Luke-Neumann/PowerMeter2/PCB Design/Final BOM.xlsx

Qty | Parts | Value | DIGI-KEY_PART_NUMBER | Device | Package | Description | DESCRIPTION | DIGI-KEY_PURCHASE_URL
1 | J2 |  | 609-3487-1-ND | CONN_03X2FEMALE_SMD | 2X3_SMD | Multi connection point. Often used as Generic Header-pin footprint for 0.1 inch spaced/style header connections
1 | D1 |  | 641-1458-1-ND | SCHOTTKY_DIODE | SMD_DIODE
1 | IC1 |  | 296-21828-1-ND | TL2575 | TO-263-6
5 | C3, C4, C10, C11, C12 | 0.1uF | 1276-1000-1-ND | 0.1UF-0603-25V-5% | 603 | 0.1µF ceramic capacitors
1 | C7 | 0.22uF | 399-7884-1-ND | 0.22UF-0603-25V-10% | 603 | 0.22µF ceramic capacitors
2 | R11, R12 | 100 | P100DBCT-ND | 100OHM-0603-1/4W-5% | 603 | 100Ω resistor
1 | C1 | 100uF | PCE3917CT-ND | CAP_POLF | F_CAP
4 | R15, R16, R17, R18 | 10k | 311-10KDCT-ND | 10KOHM-0603-1/10W-1% | 603 | 10kΩ resistor
1 | R14 | 11k | P11KDBCT-ND | RESISTOR0603 | 603 | Generic Resistor Package
1 | SW1 | 147873-1 | EG4576CT-ND | 147873-1 | SW_147873-1 | Switch Tactile OFF (ON) SPST Rectangular Button J-Bend 0.05A 24VDC 1.77N SMD T/R | Switch Tactile OFF _ON_ SPST Rectangular Button J-Bend 0.05A 24VDC 1.77N SMD T/R
1 | R13 | 150k | P150KDBCT-ND | 150KOHM-0603-1/10W-1% | 603 | 150kΩ resistor
1 | J1 | 1702473 | 277-2337-1-ND | 1702473 |  | Fixed Miniature Connectors, Spring Cage, Horizontal, SMD, 2 Pos | Fixed Miniature Connectors, Spring Cage, Horizontal, SMD, 2 Pos | https://www.digikey.com/product-detail/en/phoenix-contact/1702473/277-2337-1-ND/2643219
4 | R1, R2, R9, R10 | 1k | P1.0KBECT-ND | 1KOHM-0603-1/10W-1% | 603 | 1kΩ resistor
2 | C5, C6 | 22nF | 399-9043-1-ND | 22NF/22,000PF-0603-50V-10% | 603 | 0.022uF/22nF/22,000pF ceramic capacitors
1 | L1 | 330 uH | SRR1208-331KLCT-ND | DR125 | DR125
1 | C2 | 330uF | PCE5018CT-ND | CAP_POLF | F_CAP
2 | R3, R4 | 5.1k | P5.1KBECT-ND | RESISTOR0603 | 603 | Generic Resistor Package
4 | R5, R6, R7, R8 | 680 | P680GCT-ND | RESISTOR0603 | 0603_RESISTOR
1 | U2 | ADS1115IDGSR | 296-38849-1-ND | ADS1115IDGSR | SOP50P490X110-10N | 16-Bit ADC with Integrated MUX, PGA, Comparator, Oscillator, and Reference 10-VSSOP -40 to 125 | 16-Bit ADC with Integrated MUX, PGA, Comparator, Oscillator, and Reference 10-VSSOP -40 to 125 | https://www.digikey.com/product-detail/en/texas-instruments/ADS1115IDGSR/296-38849-1-ND/5142969
1 | U3 | AT90USB1286-MUR | AT90USB1286-MURCT-ND | AT90USB1286-MUR | PS
2 | LED2, LED3 | RED | 516-3074-1-ND | LED0603 | 0603_LED
2 | LED1, LED4 | GRN | 516-2493-1-ND | LED0603 | 0603_LED
1 | U1 | OPA2333AIDR | 296-26249-1-ND | OPA2333AIDR | D8
1 | M1 | RN4870 | RN4870-1/RM130-ND | RN4870 | RN4870
