Luke-Neumann/PowerMeter2/PCB Design/Final schematic.pdf

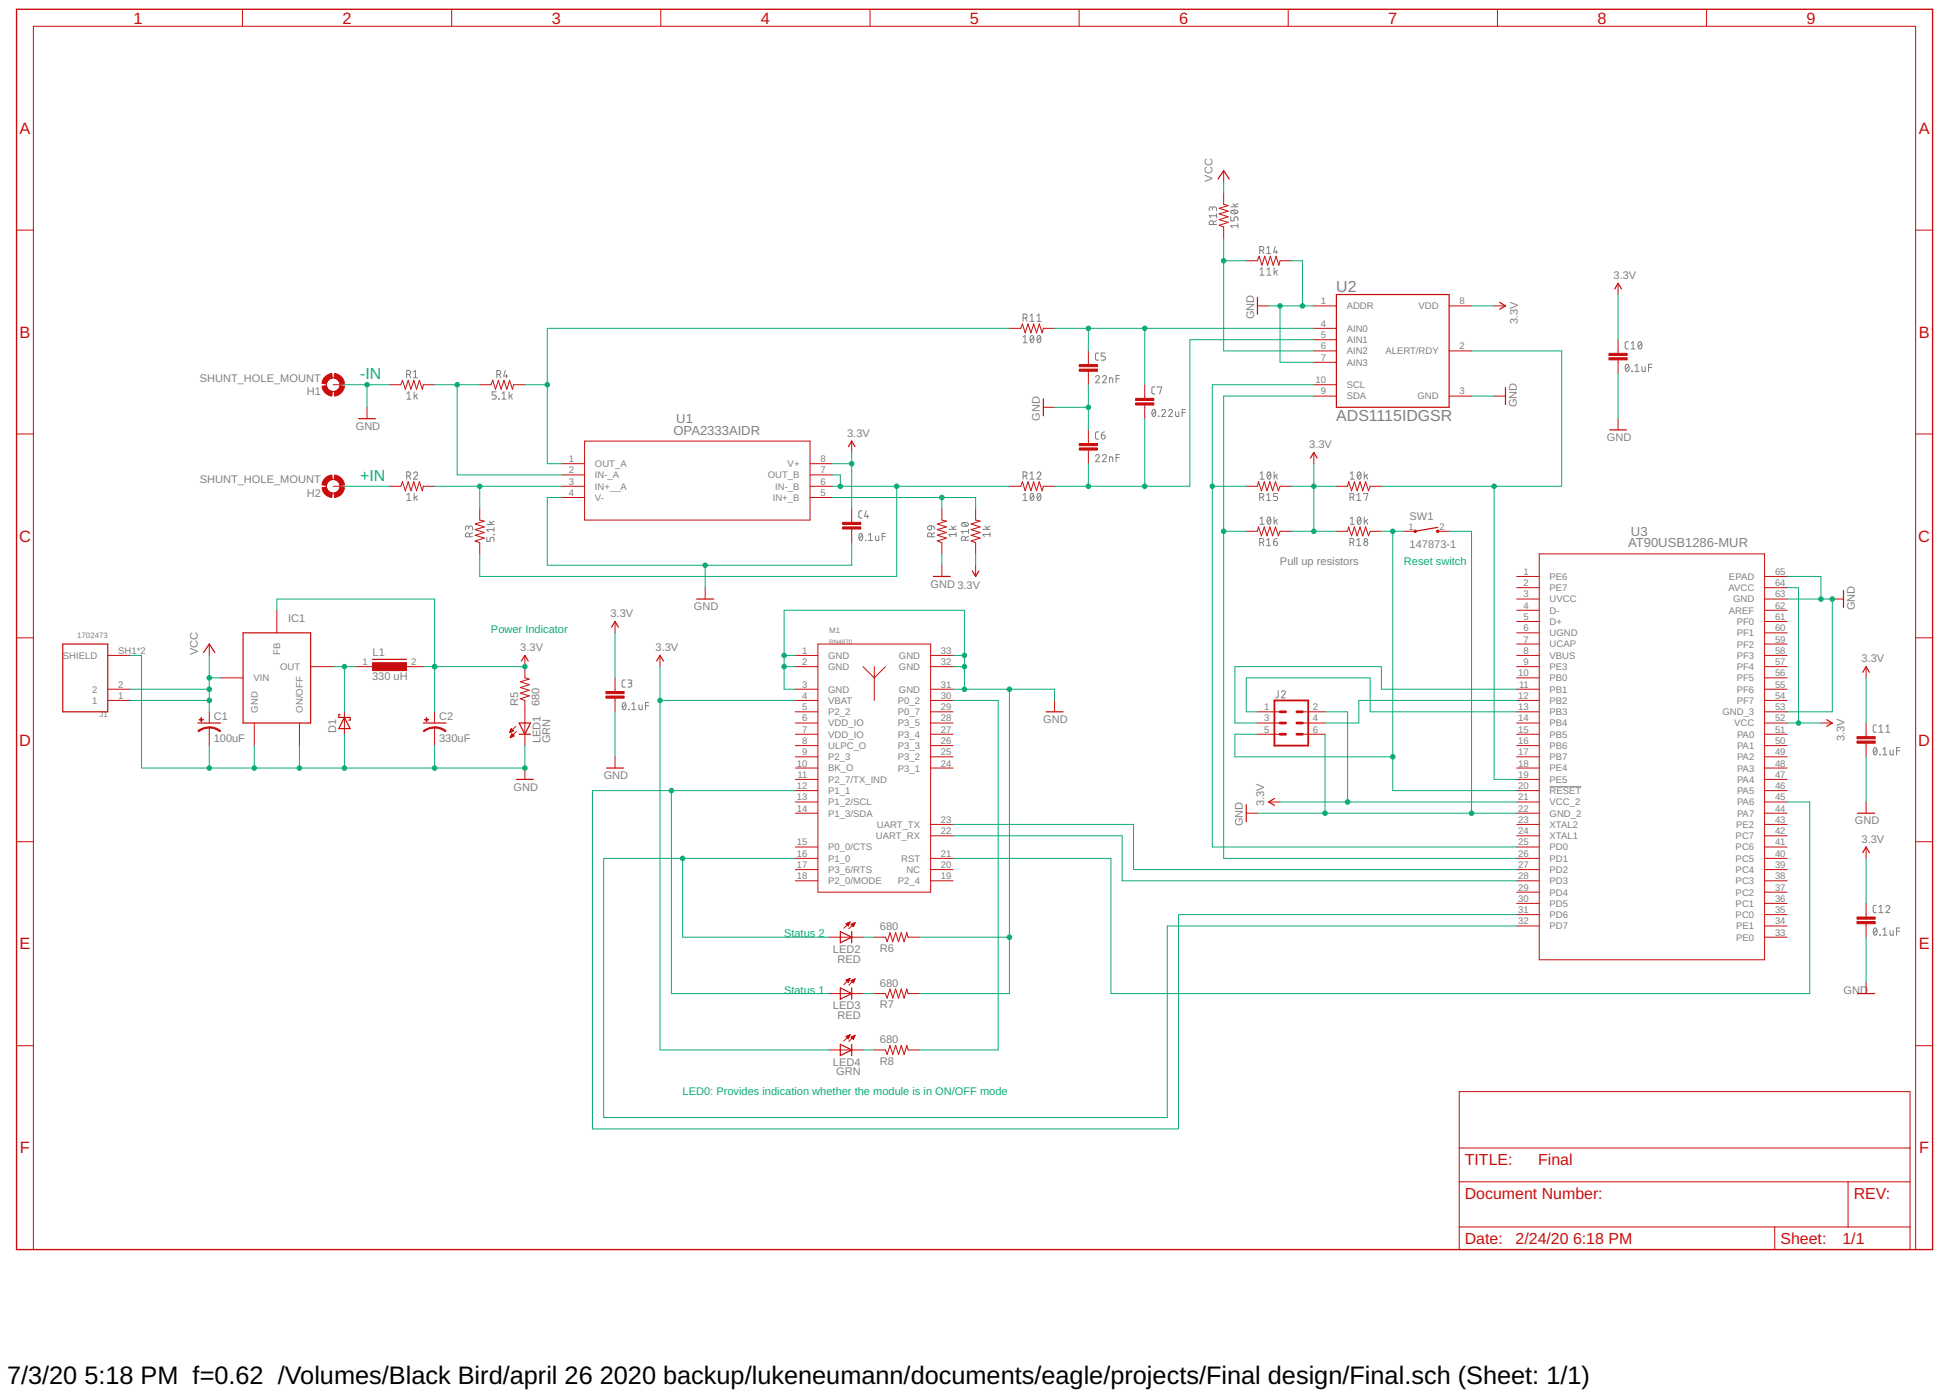
[picture p1: page 1]

LED0: Provides indication whether the module is in ON/OFF mode

7/3/20 5:18 PM f=0.62 /Volumes/Black Bird/april 26 2020 backup/lukeneumann/documents/eagle/projects/Final design/Final.sch (Sheet: 1/1)
