Luke-Neumann/PowerMeter2/PCB Design/Final.pdf

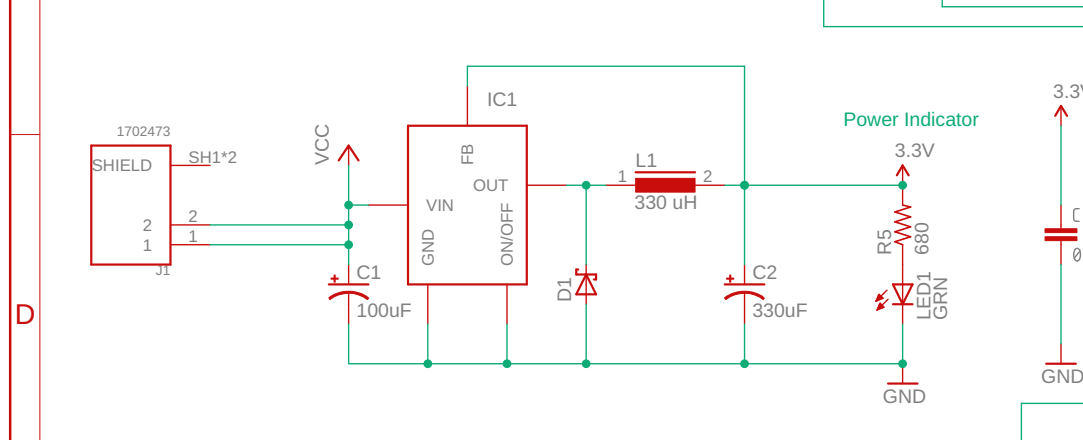
[picture p2: page 1]
