Luke-Neumann/PowerMeter2/PCB Design/Final.brd

## EAGLE design PCB Design/Final.brd (2020-07-03)

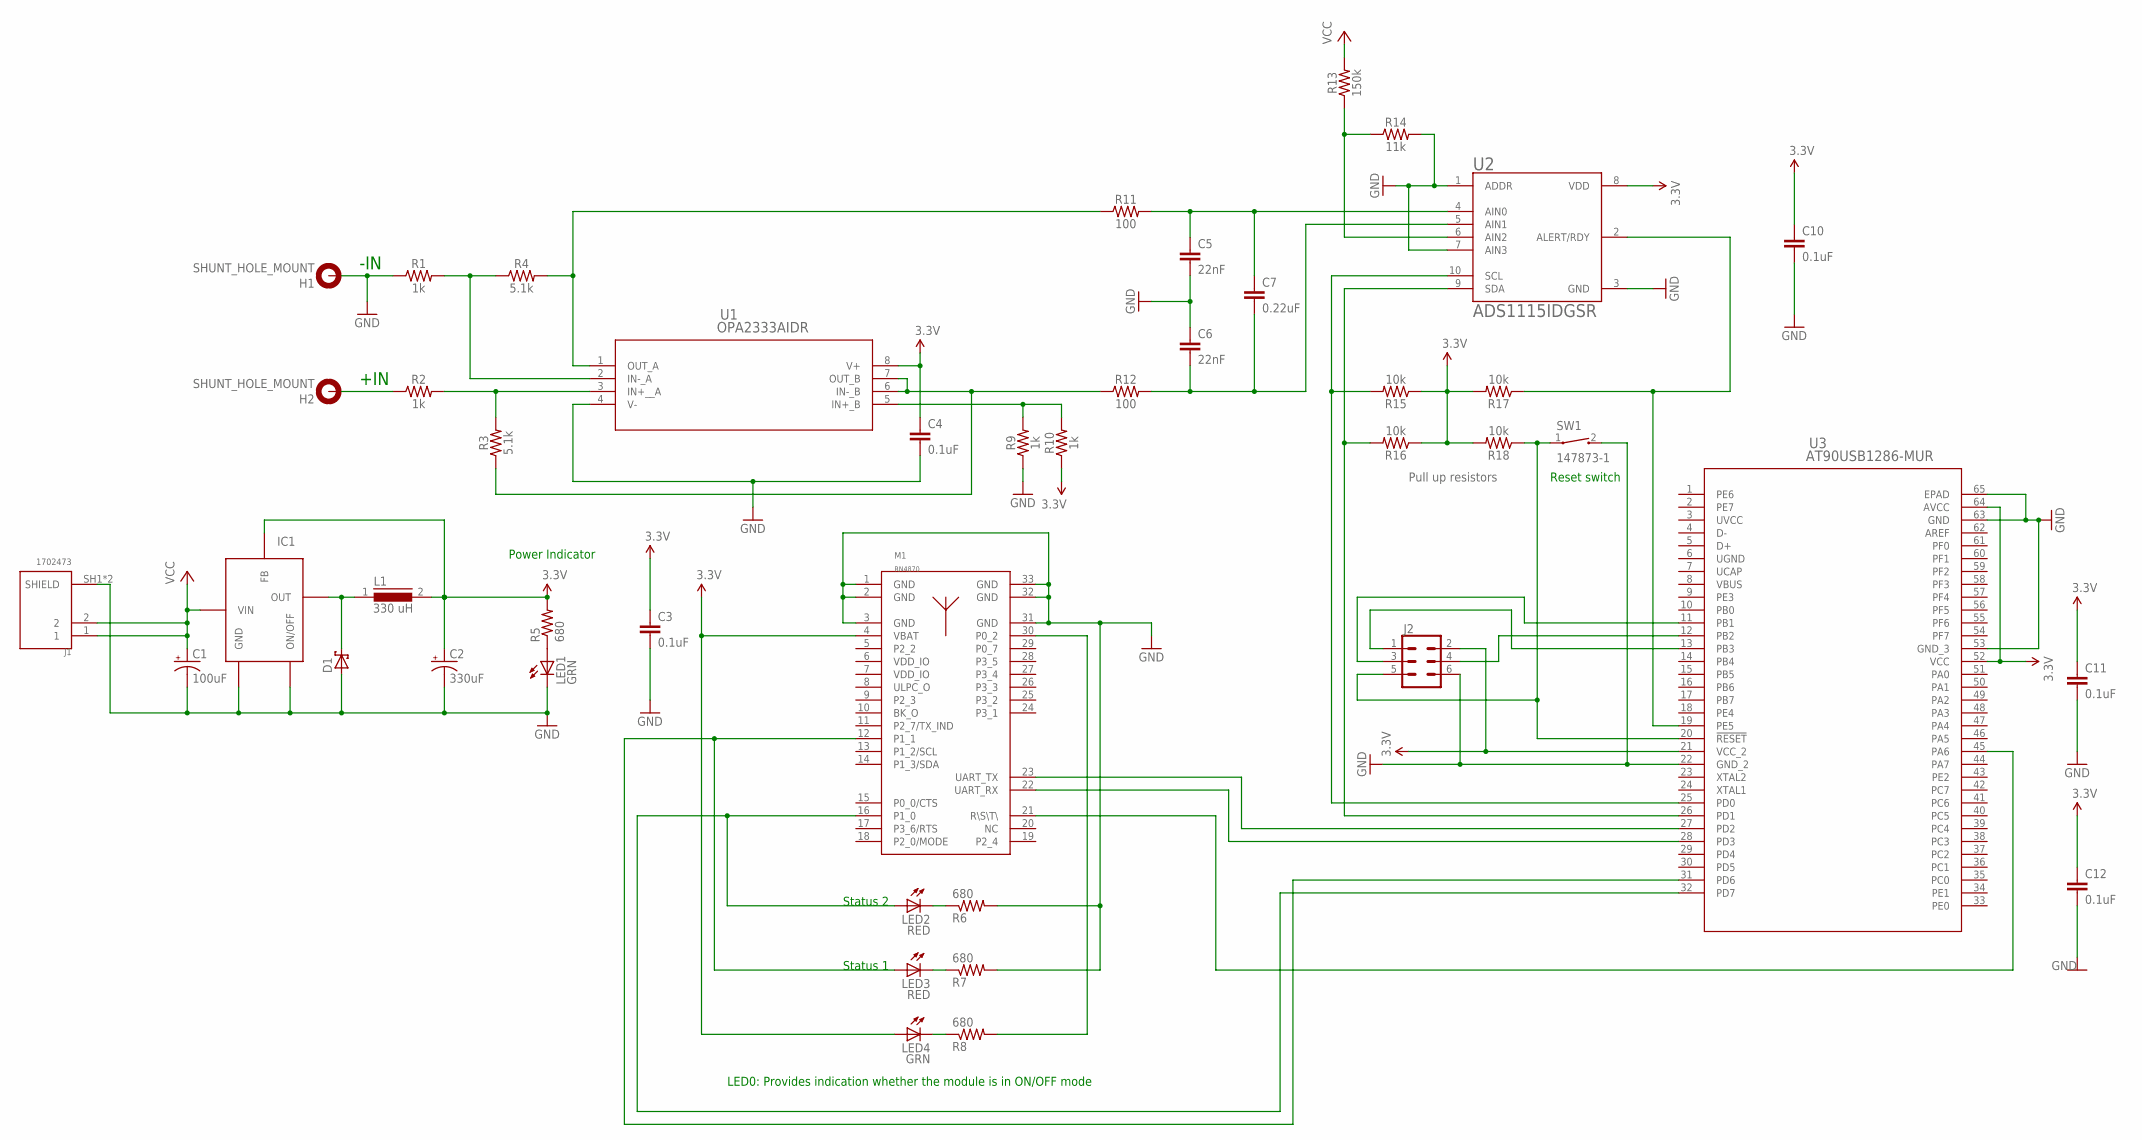
[picture p3: schematic Final.sch]

Parts:
C1: 100uF; F_CAP; DIGIKEY# PCE3917CT-ND
C2: 330uF; F_CAP; DIGIKEY# PCE3401CT-ND
C3, C4, C10, C11, C12: 0.1uF; 0603
C5, C6: 22nF; 0603
C7: 0.22uF; 0603
D1: SCHOTTKY_DIODE; SMD_DIODE
H1, H2: SHUNT_HOLE_MOUNT; 4,1-PAD
IC1: TL2575; TO-263-6
J1: 1702473; PHOENIX_1702473
J2: CONN_03X2FEMALE_SMD; 2X3_SMD
L1: 330 uH; DR125; DIGIKEY# SRR1208-102KLCT-ND
LED1, LED4: GRN; 0603_LED
LED2, LED3: RED; 0603_LED
M1: RN4870
R1, R2, R9, R10: 1k; 0603
R3, R4: 5.1k; 0603
R5, R6, R7, R8: 680; 0603_RESISTOR; DIGIKEY# P680GCT-ND
R11, R12: 100; 0603
R13: 150k; 0603
R14: 11k; 0603
R15, R16, R17, R18: 10k; 0603
SW1: 147873-1; SW_147873-1
U1: OPA2333AIDR; D8
U2: ADS1115IDGSR; SOP50P490X110-10N
U3: AT90USB1286-MUR; PS

Connections:
3.3V: C2.+, C3.1, C4.1, C10.1, C11.1, C12.1, IC1.4 (FB), J2.2, L1.2, LED4.A, M1.4 (VBAT), R5.2, R10.1, R15.1, R16.1, R17.2, R18.2, U1.8 (V+), U2.8 (VDD), U3.21 (VCC_2), U3.52 (VCC), U3.64 (AVCC)
AREF: U3.62 (AREF)
GND: C1.-, C2.-, C3.2, C4.2, C5.2, C6.1, C10.2, C11.2, C12.2, D1.A, H1.B4,1, IC1.3 (GND), IC1.5 (ON/OFF), J1.SH1 (SHIELD), J1.SH2 (SHIELD), J2.6, LED1.C, M1.1 (GND), M1.2 (GND), M1.3 (GND), M1.31 (GND), M1.32 (GND), M1.33 (GND), R1.1, R6.2, R7.2, R9.1, R14.2, SW1.2, U1.4 (V-), U2.1 (ADDR), U2.3 (GND), U2.7 (AIN3), U3.22 (GND_2), U3.53 (GND_3), U3.63 (GND), U3.65 (EPAD)
unnamed: C5.1, C7.1, R11.2, U2.4 (AIN0)
unnamed: R9.2, R10.2, U1.5 (IN+_B)
unnamed: R15.2, U2.10 (SCL), U3.25 (PD0)
unnamed: R16.2, U2.9 (SDA), U3.26 (PD1)
unnamed: H2.B4,1, R2.1
unnamed: R4.2, R11.1, U1.1 (OUT_A)
unnamed: C6.2, C7.2, R12.2, U2.5 (AIN1)
unnamed: R1.2, R4.1, U1.2 (IN-_A)
unnamed: M1.22 (UART_RX), U3.28 (PD3)
unnamed: M1.23 (UART_TX), U3.27 (PD2)
unnamed: D1.C, IC1.2 (OUT), L1.1
unnamed: LED1.A, R5.1
unnamed: R2.2, R3.2, U1.3 (IN+__A)
unnamed: R3.1, R12.1, U1.6 (IN-_B), U1.7 (OUT_B)
unnamed: LED2.C, R6.1
unnamed: LED3.C, R7.1
unnamed: LED4.C, R8.1
unnamed: M1.30 (P0_2), R8.2
unnamed: LED3.A, M1.12 (P1_1), U3.31 (PD6)
unnamed: LED2.A, M1.16 (P1_0), U3.32 (PD7)
unnamed: J2.4, U3.12 (PB2)
unnamed: J2.1, U3.13 (PB3)
unnamed: J2.3, U3.11 (PB1)
unnamed: J2.5, R18.1, SW1.1, U3.20 (!RESET)
unnamed: R17.1, U2.2 (ALERT/RDY), U3.19 (PE5)
unnamed: M1.21 (R\S\T\), U3.45 (PA6)
unnamed: R13.1, R14.1, U2.6 (AIN2)
UGND: U3.6 (UGND)
UVCC: U3.3 (UVCC)
VBUS: U3.8 (VBUS)
VCC: C1.+, IC1.1 (VIN), J1.1, J1.2, R13.2
VDD_IO: M1.6 (VDD_IO), M1.7 (VDD_IO)

Notes on the sheet:
+IN
-IN
Power Indicator
Status 1
Status 2
LED0: Provides indication whether the module is in ON/OFF mode
Reset switch
Pull up resistors

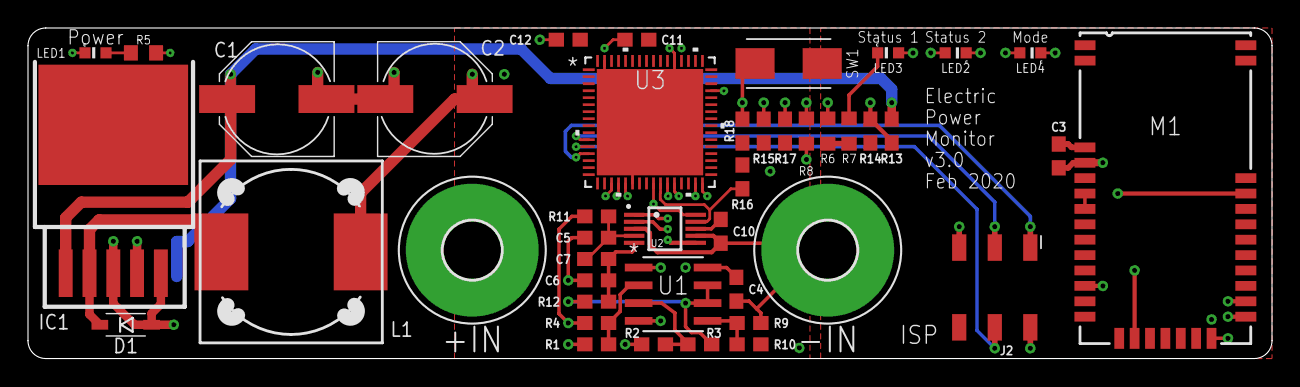
[picture p4: board Final.brd from above]

Board: 4 copper layers, 88.9 x 23.6 mm, 44 parts (1 on the bottom side), 31 nets.
