Luke-Neumann/PowerMeter2/control.h

/*
 * clockControl.h
 *
 *  Created on: Oct 6, 2018
 *      Author: neumannl
 */

#ifndef CONTROL_H_
#define CONTROL_H_

// Standard tick function.
void MainCommandControl_tick();

// Call this before you call clockControl_tick().
void MainCommandControl_init();


#endif /* CONTROL_H_ */
