Luke-Neumann/PowerMeter2/command_control.h

//
//  command_control.h
//  BLE_Power_Monitor
//
//  Created by Luke Neumann on 1/25/20.
//  Copyright © 2020 Luke Neumann. All rights reserved.
//

#ifndef command_control_h
#define command_control_h

#include <stdio.h>

void commandControl_tick();

void commandControl_init();

#endif /* command_control_h */
