Luke-Neumann/PowerMeter2/iot_ads1115.c

//
//  iot_ads1115.c
//  IOT_RV
//
//  Created by Luke Neumann on 9/24/19.
//  Copyright © 2019 Luke Neumann. All rights reserved.
//

#include "iot_ads1115.h"
//#include <avr/io.h>

void set_config_register(int8_t upper_bits, int8_t lower_bits){
    TWI_beginTransmission(ADS1115, true);
    TWI_write(CONFIG_REGISTER); // address of the config register
    TWI_write(upper_bits);
    TWI_write(lower_bits);
    TWI_endTransmission();
    _delay_ms(20);
}

void set_Hi_thresh_register(int8_t upper_bits, int8_t lower_bits){
    TWI_beginTransmission(ADS1115, true);
    TWI_write(HI_THRESH_REGISTER); // address of the config register
    TWI_write(upper_bits);
    TWI_write(lower_bits);
    TWI_endTransmission();
    _delay_ms(20);
}


void set_Lo_thresh_register(int8_t upper_bits, int8_t lower_bits){
    TWI_beginTransmission(ADS1115, true);
    TWI_write(LO_THRESH_REGISTER); // address of the config register
    TWI_write(upper_bits);
    TWI_write(lower_bits);
    TWI_endTransmission();
    _delay_ms(20);
}

uint8_t generate_upper_config_param(uint8_t OS, uint8_t MUX, uint8_t PGA,
                                    uint8_t MODE){

    return (OS<<7)|(MUX<<4)|(PGA<<1)|(MODE);
    
}
uint8_t generate_lower_config_param(uint8_t DR, uint8_t COMP_MODE,
                                    uint8_t COMP_POL, uint8_t COMP_LAT,
                                    uint8_t COMP_QUE){
    return (DR<<5)|(COMP_MODE<<4)|(COMP_POL<<3)|(COMP_LAT<<2)|(COMP_QUE) ;
}

int16_t get_conversion_register(){
    int16_t upper_bits = 0;
    int16_t lower_bits = 0;
    // prepares to read the data by pointing to the conversion register.
    TWI_beginTransmission(ADS1115, true);
    TWI_write(CONVERSION_REGISTER);
    TWI_endTransmission();
    //start_timer0();
    TWI_beginTransmission(ADS1115, false);
    upper_bits = TWI_read(false) << 8;
    lower_bits = TWI_read(true);
    TWI_endTransmission();
    //topAndPrintTimer0();
    upper_bits |= lower_bits; // This masks bits 8 to 15 and adds the rest of the data to bits 0 through 7.
    return upper_bits;
}

void run_ads1115_test(){
    
}

int16_t getBatteryVoltage(){
    uint8_t upper_bits = generate_upper_config_param(OS_HIGH, MUX_0, FSR_5, MODE_0); // enter config values
    uint8_t lower_bits = generate_lower_config_param(SPS_4, COMP_MODE_0, COMP_POL_0, COMP_LAT_0, COMP_QUE_3);
    set_config_register(upper_bits, lower_bits); // sets ADC to read the data from pins a0 and a1
    return get_conversion_register(); // read and return values
}

int16_t getCurrent(){
    uint8_t upper_bits = generate_upper_config_param(OS_HIGH, MUX_3, FSR_2, MODE_0); // enter config values
    uint8_t lower_bits = generate_lower_config_param(SPS_4, COMP_MODE_0, COMP_POL_0, COMP_LAT_0, COMP_QUE_3);
    set_config_register(upper_bits, lower_bits); // sets ADC to read the data from pins a2 and a3
    return get_conversion_register(); // read and return values
}
